mbouyer/led_ceiling_light/README.md

# led_ceiling_light
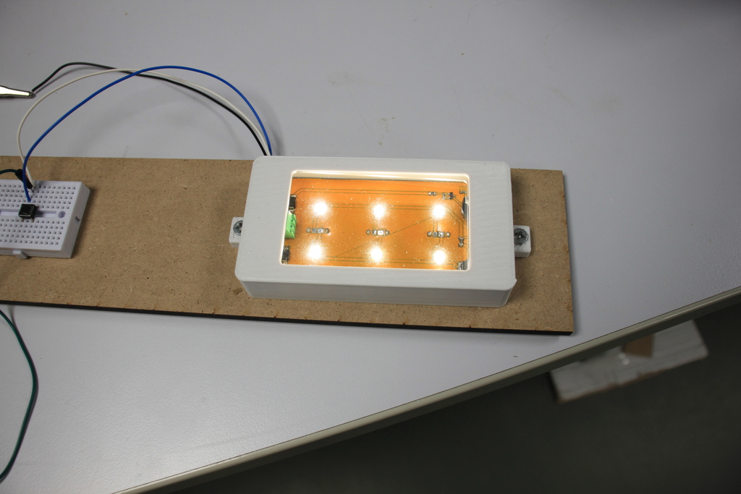
[picture p1: photo/IMG_2445-1024.JPG]

Plafonier à LEDs 12V pour bateau, avec 2 puissances (puissance réduite en navigation)
