mbouyer/led_ceiling_light/CAD/front-plexi.dxf

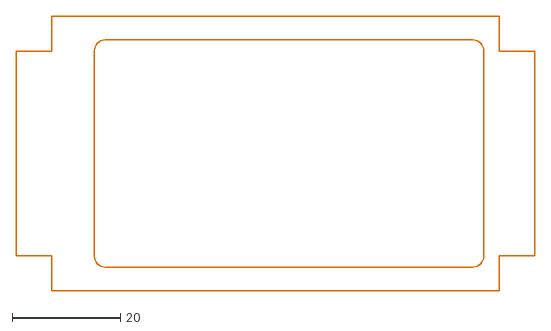
[picture p2: CAD file, 2023-02-19]
CAD/front-plexi.dxf
95.8 x 50.8
