mbouyer/led_ceiling_light/CAD/back.stl

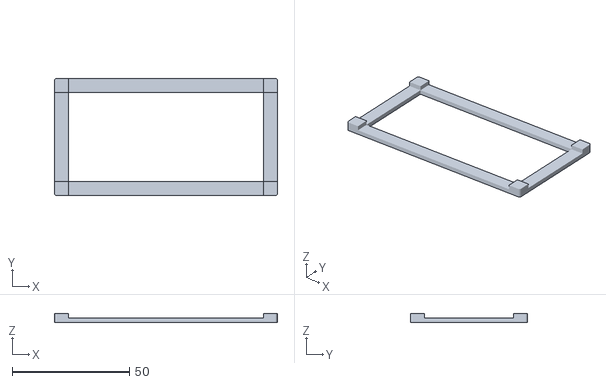
[picture p3: CAD file, 2023-02-19]
CAD/back.stl
95.0 x 50.0 x 4.00
