mbouyer/led_ceiling_light/CAD/front.stl

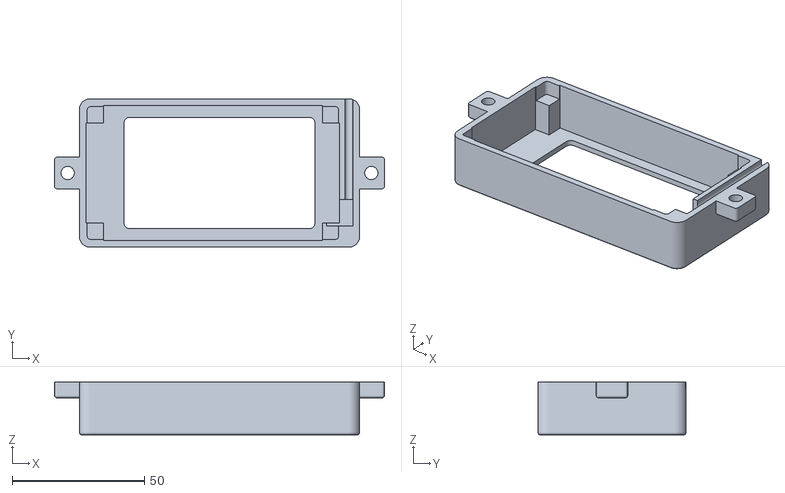
[picture p4: CAD file, 2023-02-19]
CAD/front.stl
125.0 x 56.2 x 20.0
