mbouyer/led_ceiling_light/CAD/PCB.dxf

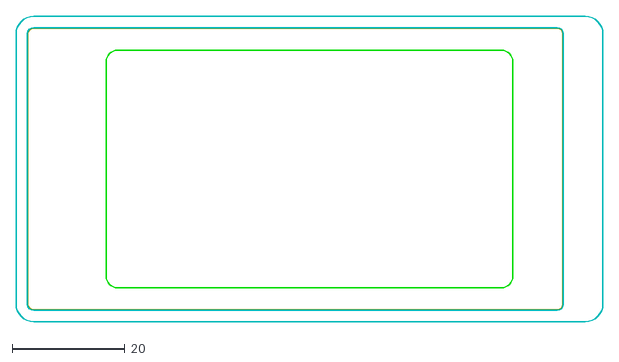
[picture p5: CAD file, 2023-02-15]
CAD/PCB.dxf
104.2 x 54.2
