mbouyer/led_ceiling_light/CAD/params.scad

pcb_L = 95;
pcb_l = 50;

h_support = 2;
h_space = 2;
taille_plots = 6;

h_pcb = 1.6;
h_electro = 4.1;
h_front = 20;
