mbouyer/led_ceiling_light/hardware/led_ceiling_light.kicad_pcb

## KiCad design hardware/led_ceiling_light.kicad_pcb (2023-02-24)

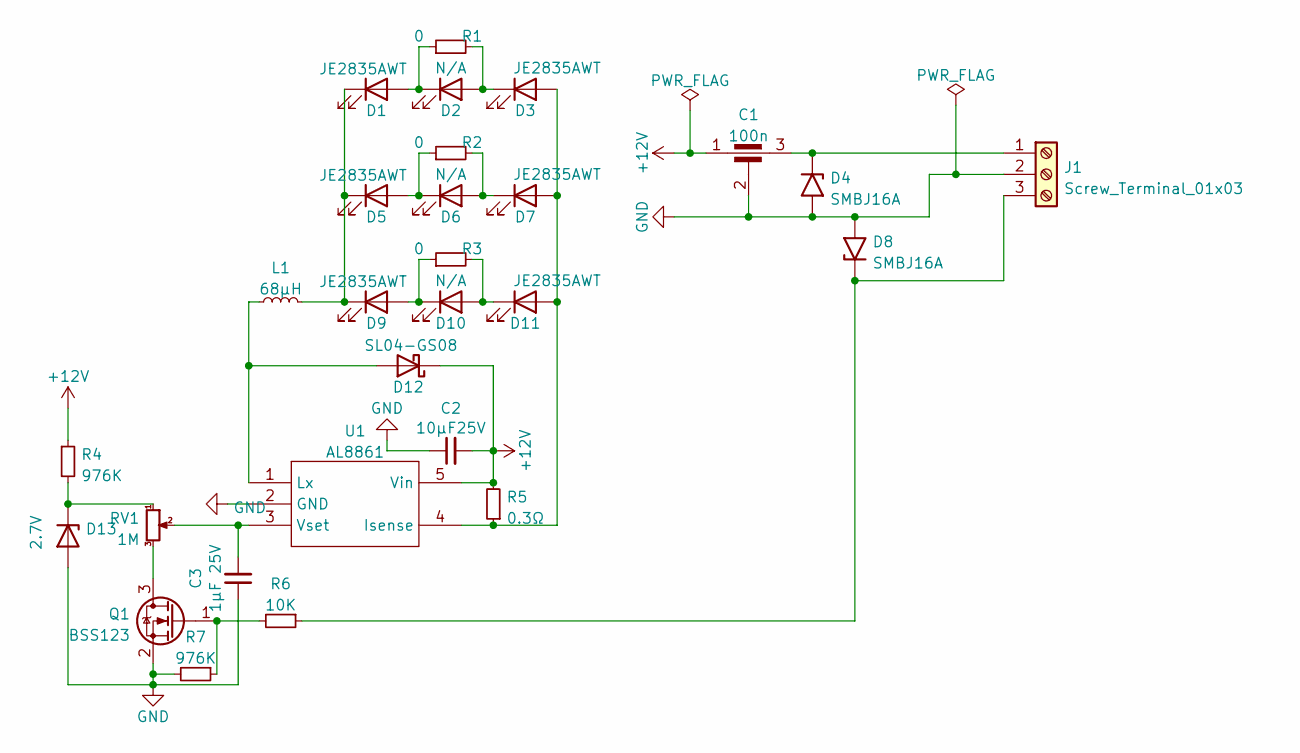
[picture p6: schematic led_ceiling_light.kicad_sch]

Parts:
C1: 100n; C_filter_0805
C2: 10µF25V; C_1210_3225Metric_Pad1.33x2.70mm_HandSolder
C3: 1µF 25V; C_0805_2012Metric_Pad1.18x1.45mm_HandSolder
D1, D3, D5, D7, D9, D11: JE2835AWT; LED_PLCC_2835_Handsoldering
D2, D6, D10: N/A; LED_PLCC_2835_Handsoldering
D4, D8: SMBJ16A; D_SMB_Handsoldering
D12: SL04-GS08; D_SMF
D13: 2.7V; D_MiniMELF_Handsoldering
J1: Screw_Terminal_01x03; TerminalBlock_TE_282834-3_1x03_P2.54mm_Horizontal
L1: 68µH; L_Taiyo-Yuden_NR-80xx_HandSoldering
Q1: BSS123; SOT-23
R1, R2, R3: 0; R_Axial_DIN0204_L3.6mm_D1.6mm_P7.62mm_Horizontal
R4, R7: 976K; R_0603_1608Metric_Pad0.98x0.95mm_HandSolder
R5: 0.3Ω; R_1206_3216Metric_Pad1.30x1.75mm_HandSolder
R6: 10K; R_0805_2012Metric_Pad1.20x1.40mm_HandSolder
RV1: 1M; Potentiometer_Piher_PT-10-V10_Vertical
U1: AL8861; TSOT-23-5_HandSoldering

Connections:
+12V: C1.1, C2.2, D12.1 (K), R4.1, R5.2, U1.5 (Vin)
GND: C1.2, C2.1, C3.1, D4.2 (A2), D8.2 (A2), D13.2 (A), J1.2, Q1.2 (S), R7.2, U1.2 (GND)
unnamed: C1.3, D4.1 (A1), J1.1
unnamed: C3.2, RV1.2, U1.3 (Vset)
unnamed: D1.1 (K), D5.1 (K), D9.1 (K), L1.2
unnamed: D1.2 (A), D2.1 (K), R1.1
unnamed: D2.2 (A), D3.1 (K), R1.2
unnamed: D5.2 (A), D6.1 (K), R2.1
unnamed: D6.2 (A), D7.1 (K), R2.2
unnamed: D8.1 (A1), J1.3, R6.1
unnamed: D9.2 (A), D10.1 (K), R3.1
unnamed: D10.2 (A), D11.1 (K), R3.2
unnamed: D3.2 (A), D7.2 (A), D11.2 (A), R5.1, U1.4 (Isense)
unnamed: D12.2 (A), L1.1, U1.1 (Lx)
unnamed: D13.1 (K), R4.2, RV1.1
unnamed: Q1.1 (G), R6.2, R7.1
unnamed: Q1.3 (D), RV1.3

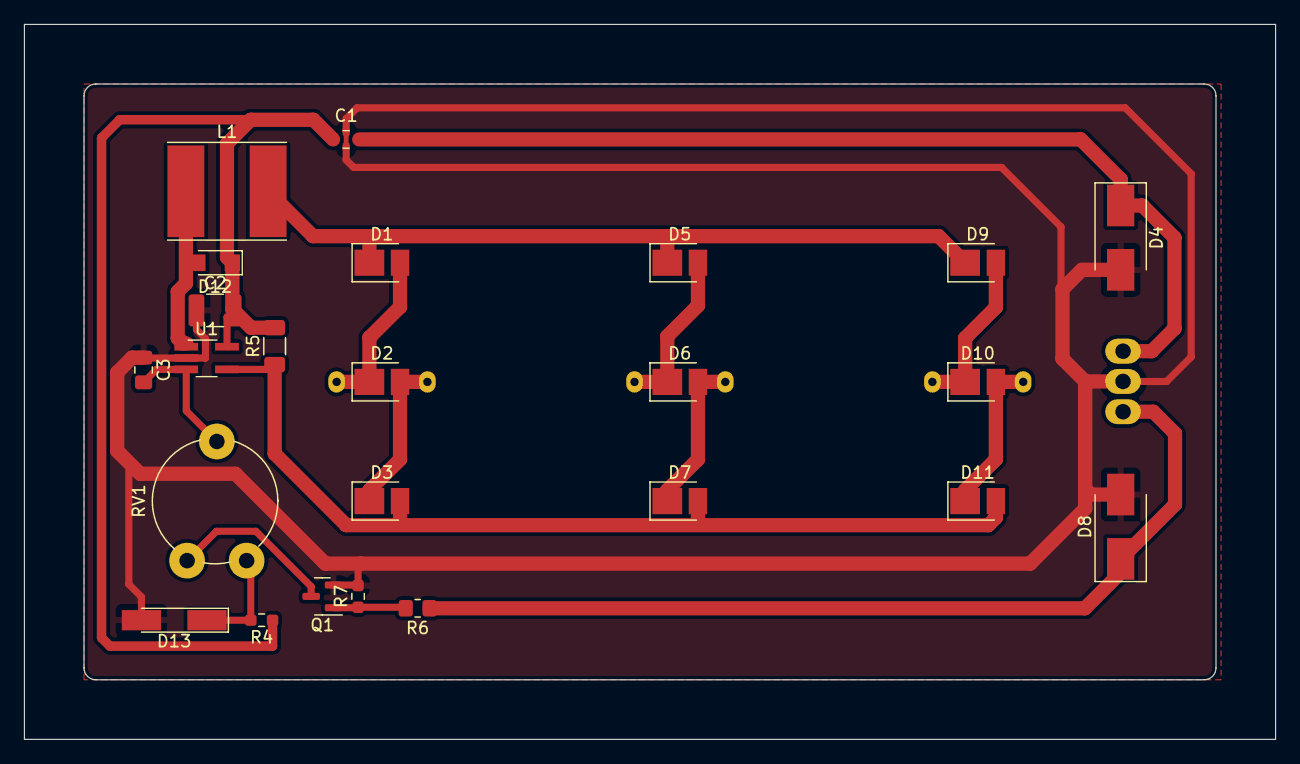
[picture p7: board led_ceiling_light.kicad_pcb from above]

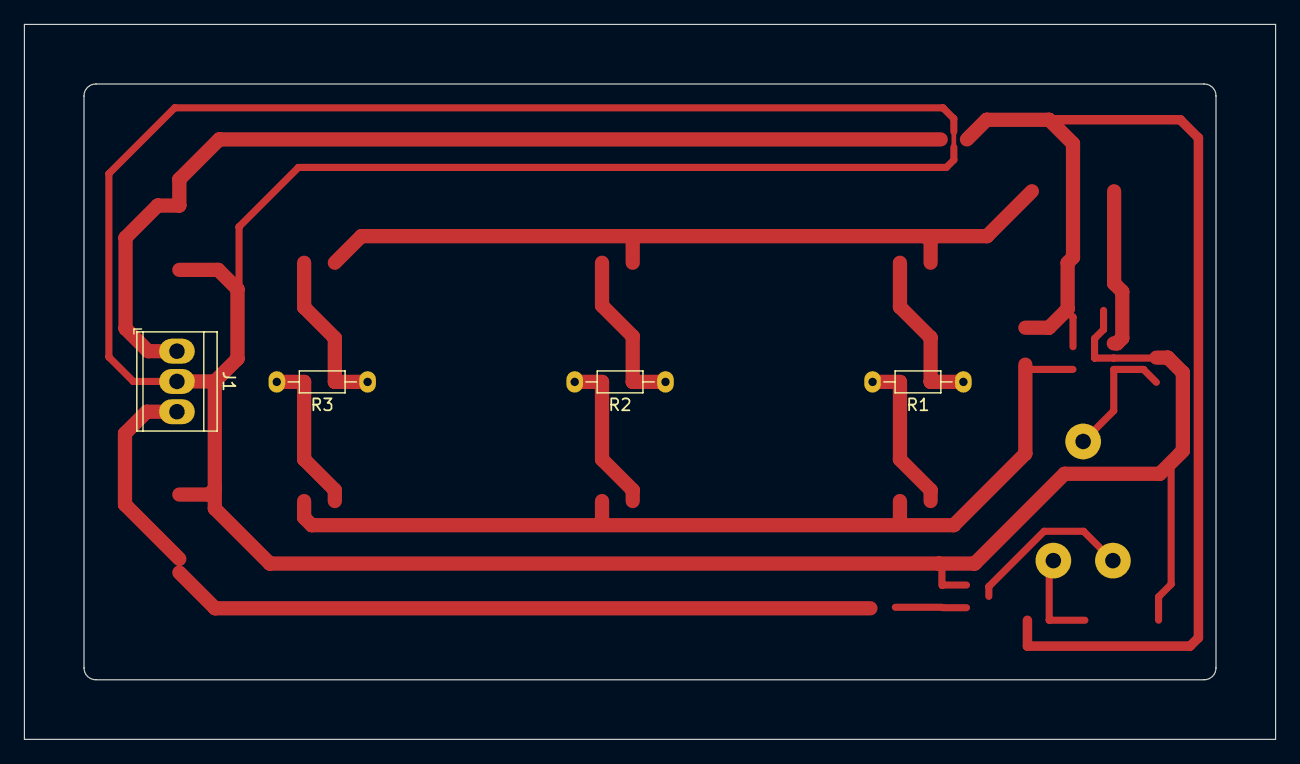
[picture p8: board led_ceiling_light.kicad_pcb from below]

Board: 2 copper layers, 105.0 x 60.0 mm, 28 parts (4 on the bottom side), 17 nets.
