mbouyer/led_ceiling_light/(commit log)

2022-12-13 Initial commit. Schematic almost complete; a few more footprint association needed.
    [led_ceiling_light.kicad_pcb, led_ceiling_light.kicad_sch]
2022-12-13 Fix some DRC issues; add more footprints.
    [led_ceiling_light.kicad_sch]
2022-12-13 More part numbers and footprint
    [led_ceiling_light.kicad_sch]
2022-12-13 One last P/N
    [led_ceiling_light.kicad_sch]
2023-01-06 complete P/N and footprints
    [led_ceiling_light.kicad_sch]
2023-01-06 Dedup resistor value
    [led_ceiling_light.kicad_sch]
2023-01-06 Add PCB design
    [led_ceiling_light.kicad_pcb]
2023-01-27 normalise and update P/N, update footprint to match
    [led_ceiling_light.kicad_sch]
2023-01-27 Update PCB after P/N adjustements
    [led_ceiling_light.kicad_pcb]
2023-01-27 Run cleanup tracks
    [led_ceiling_light.kicad_pcb]
2023-01-29 Final pass on part numbers
    [led_ceiling_light.kicad_sch]
2023-01-31 shrink PCB by 5mm to make space for cable. Round corners
    [led_ceiling_light.kicad_pcb]
2023-01-31 Add 3d model for a box
    [PCB.dxf, back.scad, front.scad, params.scad]
2023-02-01 Sync with P/N update
    [led_ceiling_light.kicad_pcb]
2023-02-01 Add optional a 3rd LED in serie (so we can have a 3x2 or 3x3 matrix). Re-annotate whole schematic
    [led_ceiling_light.kicad_pcb, led_ceiling_light.kicad_sch]
2023-02-01 Cosmetic adjust tracks
    [led_ceiling_light.kicad_pcb]
2023-02-02 PCB: show PCB holder place
    [led_ceiling_light.kicad_pcb]
2023-02-02 Make room to the back for the connector, which implies a PCB much closer to the front.
    [front.scad, params.scad]
2023-02-07 Increase clearance to 0.3mm
    [led_ceiling_light.kicad_pcb]
2023-02-09 Generate fabrication files
    [led_ceiling_light.kicad_pcb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]
2023-02-10 Adjust connector drill size for BG9.S riverts
    [led_ceiling_light.kicad_pcb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]
2023-02-13 Move conector back to the front (we can use BG9.S rivets), so move PCB closer to the back of the box again
    [front.scad, params.scad]
2023-02-13 BG9.S rivets needs 1.3mm hole
    [led_ceiling_light.kicad_pcb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]
2023-02-15 Add a hole in the back of the box, for better cooling
    [back.scad]
2023-02-15 Add a hole in the front box for a plexiglass window.
    [PCB.dxf, front.scad]
2023-02-15 Show plexiglass window on the PCB
    [led_ceiling_light.kicad_pcb]
2023-02-19 Add a way to project the front part of the box to draw the plexiglass shape for machining. Add generated files: back.stl, front.stl and front-plexi.dxf
    [back.stl, front-plexi.dxf, front.scad, front.stl]
2023-02-24 Fix D13 footprint
    [led_ceiling_light.kicad_pcb, led_ceiling_light.kicad_sch]
